MECTsrl/stk_board/README.md

# stk_board
Starter Kit Board: a nice electronic board for playing with digital and analog I/O.

It is part of the MECT Starter Kit http://www.mect.it/en/products/kit/starter-kit/starter-kit-tpac1007/.
