MECTsrl/stk_board/STKhw/cs1506_1_stk01.PDF

# LATO COMPONENTI CS1506-1

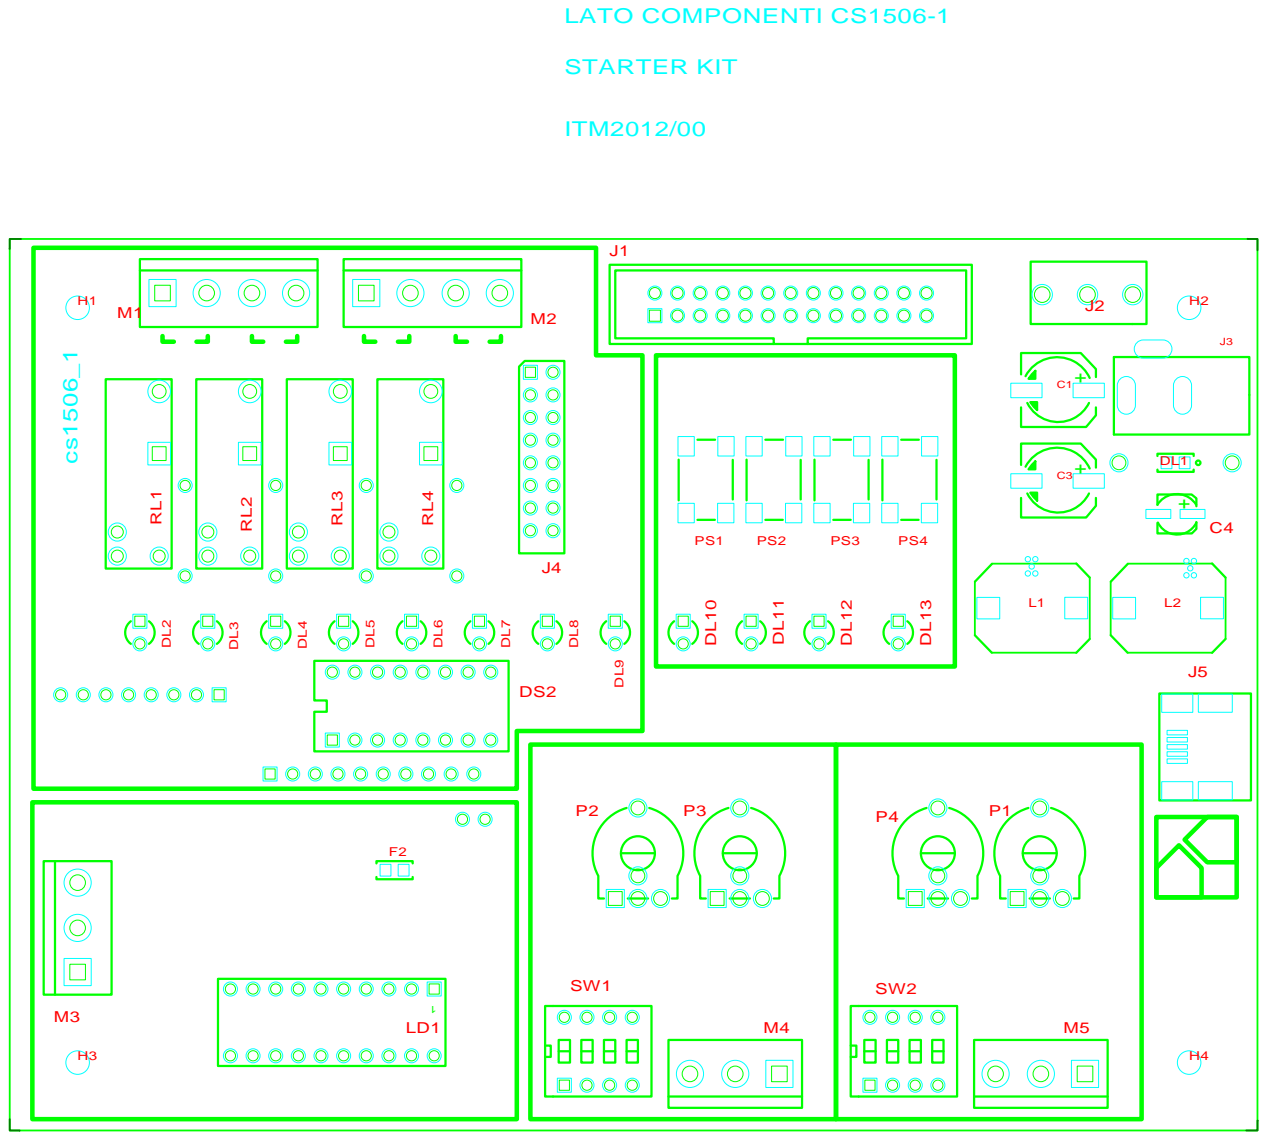
[picture p2: page 1]
