MECTsrl/stk_board/STKhw/cs1506_1_stk01_ls.PDF

# SERIGRAFIA L.S. CS1506_1

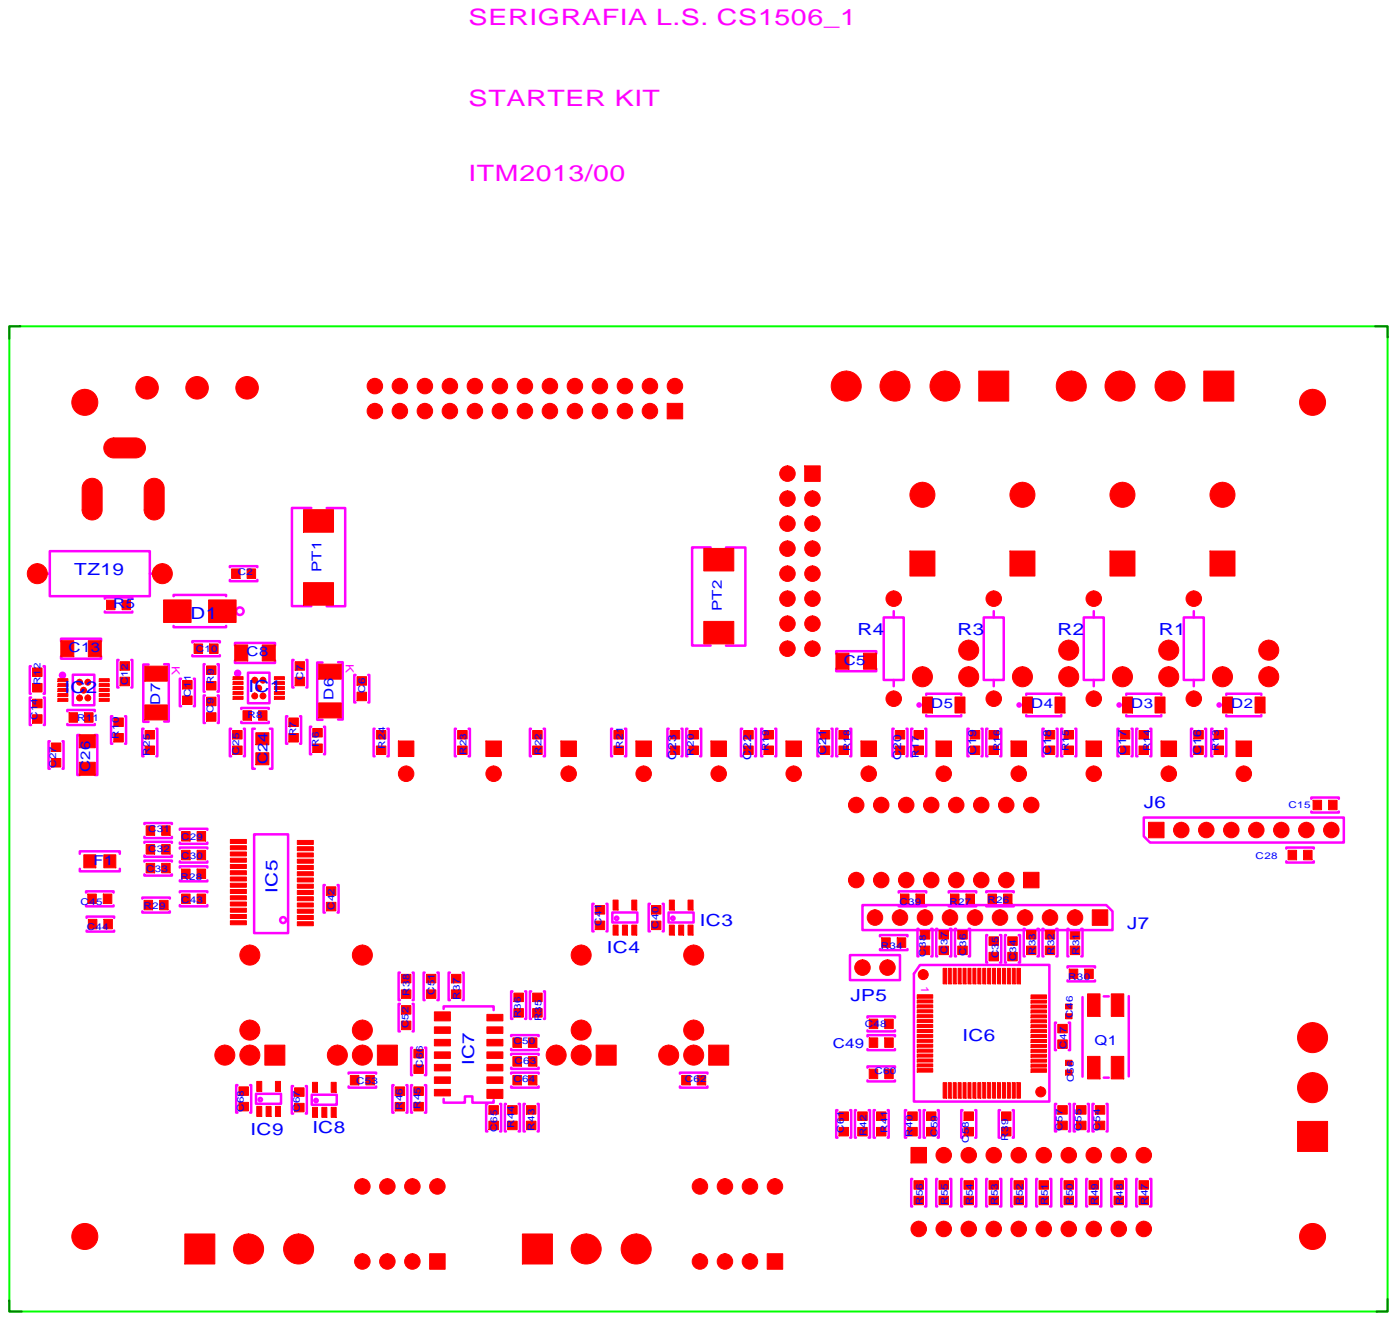
[picture p3: page 1]
