MECTsrl/stk_board/STKhw/lc_cs1506_1.pdf

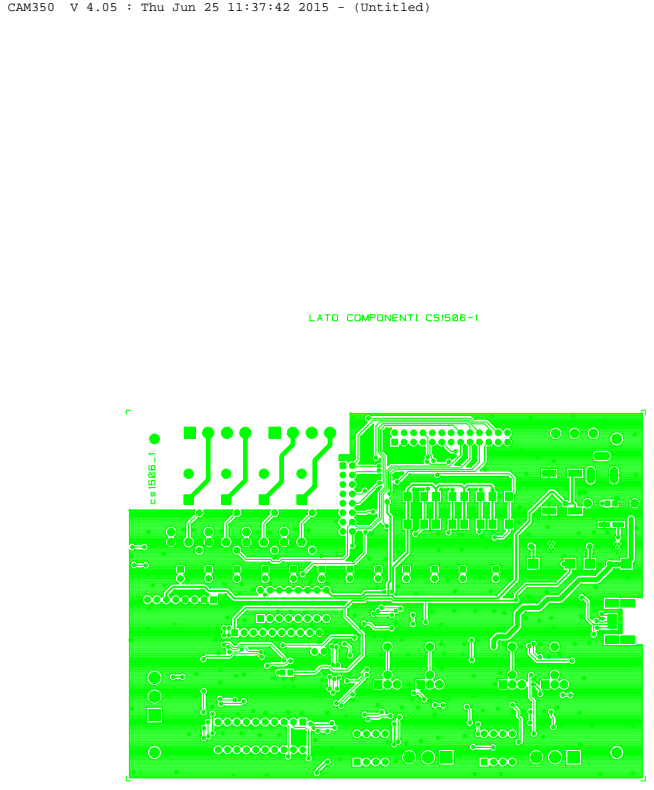
[picture p4: page 1]

CAM350 V 4.05 : Thu Jun 25 11:37:42 2015 - (Untitled)
