MECTsrl/stk_board/STKhw/ls_cs1506_1.pdf

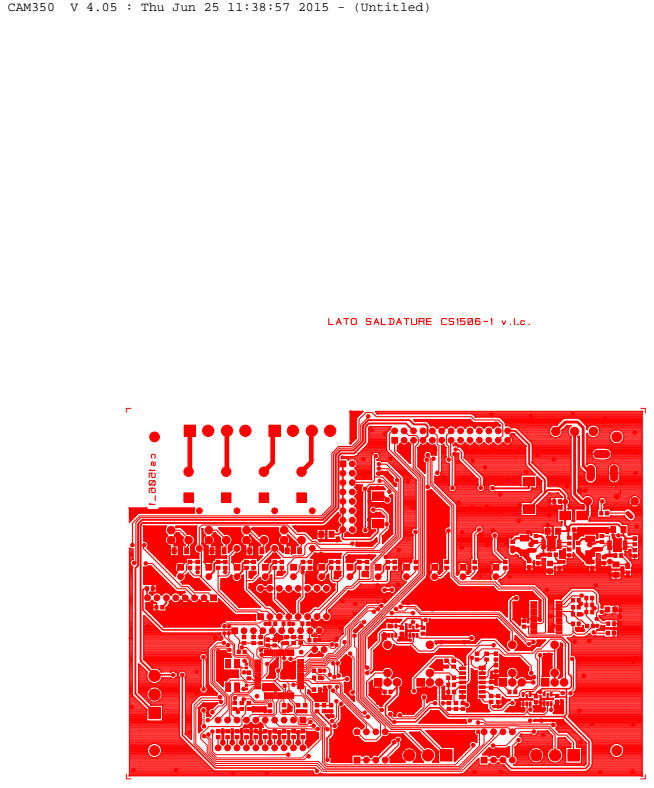
[picture p5: page 1]

CAM350 V 4.05 : Thu Jun 25 11:38:57 2015 - (Untitled)
