MECTsrl/stk_board/(commit log)

2015-06-15 Schematic 1.0
    STK board schematic
2015-06-25 Added layout and Gerber PDF files
